Souber-ismael/Firmware-temps-r-el-STM32-FreeRTOS-Data-Logger-/image/monotoring system.jpeg

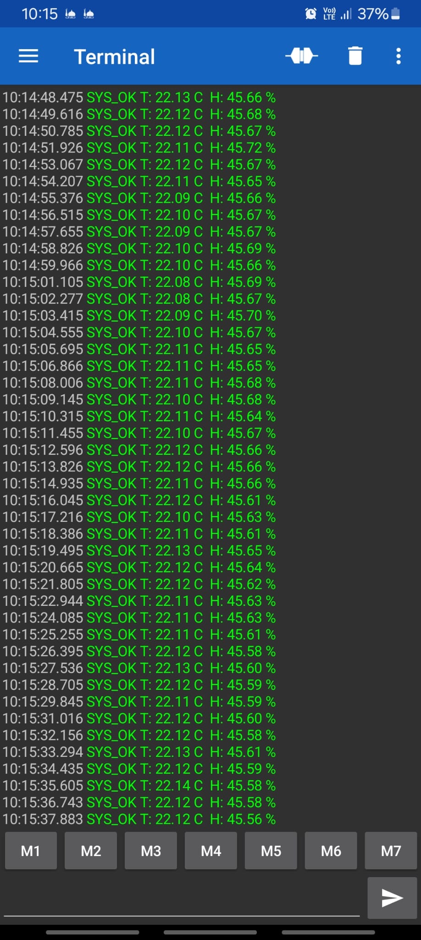
image/monotoring system.jpeg
