Souber-ismael/Firmware-temps-r-el-STM32-FreeRTOS-Data-Logger-/image/projet.jpeg

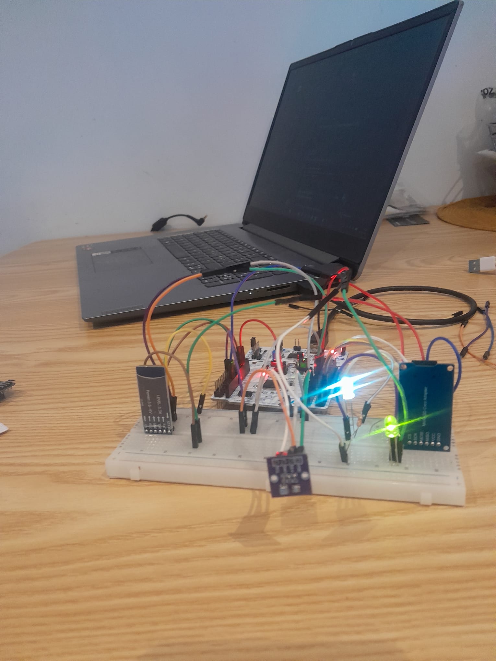
image/projet.jpeg
