Souber-ismael/Firmware-temps-r-el-STM32-FreeRTOS-Data-Logger-/image/recovery 3 ok.jpeg

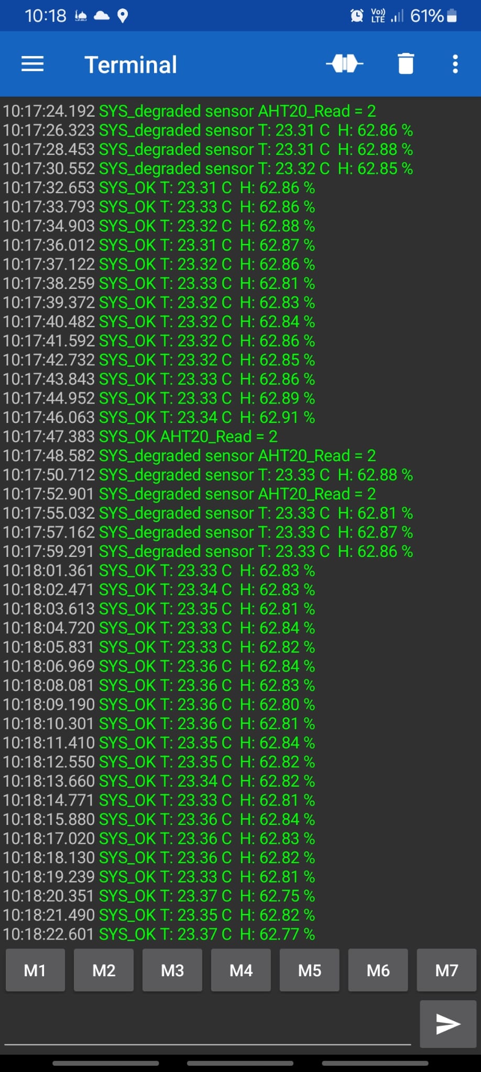
image/recovery 3 ok.jpeg
