Souber-ismael/Firmware-temps-r-el-STM32-FreeRTOS-Data-Logger-/image/the laptop.jpeg

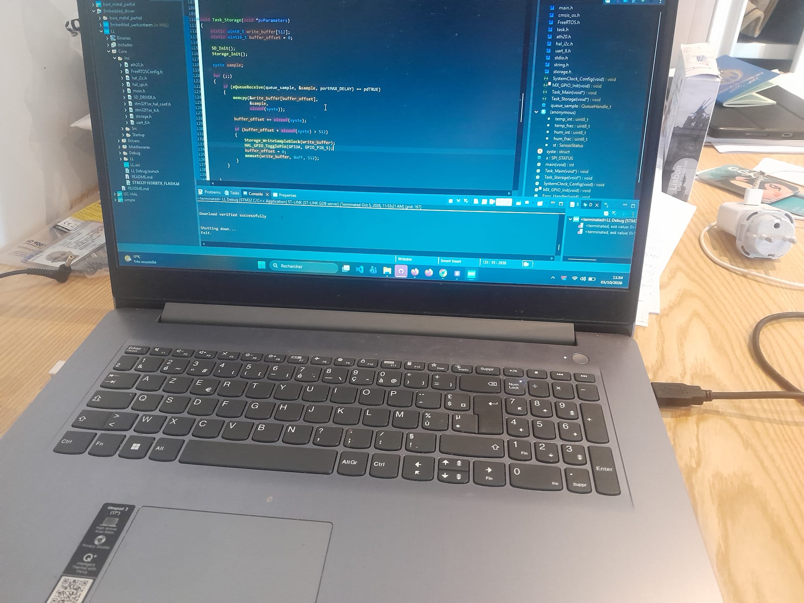
image/the laptop.jpeg
