Souber-ismael/Firmware-temps-r-el-STM32-FreeRTOS-Data-Logger-/tests_SASE/test_projet/coverage.aht20_convert.c.4a7f78591ac0107006967368135403f9.html

# GCC Code Coverage Report

Directory: | ./
Coverage: | low: ≥ 0% medium: ≥ 75.0% high: ≥ 90.0%

| Coverage | Exec / Excl / Total
Lines: | 100.0% | 31 / 0 / 31
Functions: | 100.0% | 1 / 0 / 1
Branches: | 94.4% | 17 / 0 / 18

Driver/AHT20/aht20_convert.c

30 covered 0 uncovered 1 partial covered 0 excluded

Line | Branch | Exec | Source
1 | | | /*
2 | | | * aht20_convert.c
3 | | | *
4 | | | * Created on: Oct 12, 2026
5 | | | * Author: admin
6 | | | */
7
8
9
10 | | | #include "aht20_convert.h"
11 | | | #include "stddef.h"
12
13 | | 136 | SensorStatus aht20_convert(
14 | | | const uint8_t data[6],
15 | | | int16_t *temp_int,
16 | | | uint8_t *temp_frac,
17 | | | uint8_t *hum_int,
18 | | | uint8_t *hum_frac)
19 | | | {
20 | 3/4 ✓ Branch 2 → 3 taken 136 times. ✗ Branch 2 → 7 not taken. ✓ Branch 3 → 4 taken 123 times. ✓ Branch 3 → 7 taken 13 times. | 136 | if (data == NULL
21 | 4/4 ✓ Branch 4 → 5 taken 121 times. ✓ Branch 4 → 7 taken 2 times. ✓ Branch 5 → 6 taken 119 times. ✓ Branch 5 → 7 taken 2 times. | 123 | temp_int == NULL || temp_frac == NULL
22 | 2/2 ✓ Branch 6 → 7 taken 1 time. ✓ Branch 6 → 8 taken 118 times. | 119 | hum_int == NULL || hum_frac == NULL)
23 | | | {
24 | | 18 | return SENSOR_STATUS_INVALID_DATA;
25 | | | }
26
27 | | | /* Extraction des valeurs brutes sur 20 bits */
28 | | 118 | uint32_t rawHum =
29 | | 118 | ((uint32_t)data[1] << 12)
30 | | 118 | ((uint32_t)data[2] << 4)
31 | | 118 | ((uint32_t)data[3] >> 4);
32
33 | | 118 | uint32_t rawTemp =
34 | | 118 | ((uint32_t)(data[3] & 0x0F) << 16)
35 | | 118 | ((uint32_t)data[4] << 8)
36 | | 118 | (uint32_t)data[5];
37
38 | | | /* Calcul en centiÃ¨mes pour Ã©viter les float */
39 | | 118 | uint32_t hum_centi =
40 | | 118 | (uint32_t)(((uint64_t)rawHum * 10000ULL)
41 | | 118 | / 1048576ULL);
42
43 | | 118 | int32_t temp_centi =
44 | | 118 | (int32_t)(((uint64_t)rawTemp * 20000ULL)
45 | | 118 | / 1048576ULL) - 5000;
46
47 | | | /* SÃ©parer partie entiÃ¨re et fraction */
48 | | 118 | *hum_int = (uint8_t)(hum_centi / 100);
49 | | 118 | *hum_frac = (uint8_t)(hum_centi % 100);
50
51 | | 118 | *temp_int = (int16_t)(temp_centi / 100);
52
53 | | 118 | int32_t frac = temp_centi % 100;
54 | 2/2 ✓ Branch 8 → 9 taken 26 times. ✓ Branch 8 → 10 taken 92 times. | 118 | if (frac < 0)
55 | | | {
56 | | 26 | frac = -frac;
57 | | | }
58
59 | | 118 | *temp_frac = (uint8_t)frac;
60
61 | | | /* VÃ©rification des plages */
62 | 2/2 ✓ Branch 10 → 11 taken 97 times. ✓ Branch 10 → 13 taken 21 times. | 118 | if (*temp_int > SENSOR_TEMP_MAX
63 | 2/2 ✓ Branch 11 → 12 taken 81 times. ✓ Branch 11 → 13 taken 16 times. | 97 | *temp_int < SENSOR_TEMP_MIN
64 | 2/2 ✓ Branch 12 → 13 taken 3 times. ✓ Branch 12 → 14 taken 78 times. | 81 | *hum_int > SENSOR_HUM_MAX)
65 | | | {
66 | | 40 | return SENSOR_STATUS_INVALID_DATA;
67 | | | }
68
69 | | 78 | return SENSOR_STATUS_OK;
70 | | | }
71

Created using GCOVR (Version 8.6) (http://gcovr.com/en/8.6) at 2026-10-18 17:52:37
