Souber-ismael/Firmware-temps-r-el-STM32-FreeRTOS-Data-Logger-/tests_SASE/test_projet/coverage.functions.html

# GCC Code Coverage Report

Directory: | ./

| Coverage | Exec | Excl | Total
Lines: | 98.3% | 118 | 0 | 120
Functions: | 100.0% | 10 | 0 | 10
Branches: | 94.8% | 55 | 0 | 58

Function (File:Line)

Calls

Lines

Branches

Blocks

Storage_Init (Driver/storage/storage.c:28)

called 57 times

100.0%

100.0%

100.0%

Storage_SaveMetadata (Driver/storage/storage.c:53)

called 76 times

100.0%

-%

100.0%

Storage_WriteSampleBlock (Driver/storage/storage.c:72)

called 57 times

100.0%

100.0%

100.0%

aht20_convert (Driver/AHT20/aht20_convert.c:13)

called 136 times

100.0%

94.4%

100.0%

supervisor_check_timeouts (APP/task_supervisor/supervisor_logic.c:118)

called 777 times

100.0%

100.0%

100.0%

supervisor_ok_sensor (APP/task_supervisor/supervisor_logic.c:100)

called 567 times

100.0%

100.0%

100.0%

supervisor_ok_storage (APP/task_supervisor/supervisor_logic.c:109)

called 210 times

100.0%

100.0%

100.0%

supervisor_process_event (APP/task_supervisor/supervisor_logic.c:33)

called 714 times

92.3%

88.2%

94.7%

supervisor_reset (APP/task_supervisor/supervisor_logic.c:22)

called 378 times

100.0%

-%

100.0%

supervisor_update (APP/task_supervisor/supervisor_logic.c:81)

called 861 times

100.0%

100.0%

100.0%

Created using GCOVR (Version 8.6) (http://gcovr.com/en/8.6) at 2026-10-18 17:52:37
