Souber-ismael/Firmware-temps-r-el-STM32-FreeRTOS-Data-Logger-/tests_SASE/test_projet/coverage.html

# GCC Code Coverage Report

Directory: | ./
Coverage: | low: ≥ 0% medium: ≥ 75.0% high: ≥ 90.0%

| Coverage | Exec / Excl / Total
Lines: | 98.3% | 118 / 0 / 120
Functions: | 100.0% | 10 / 0 / 10
Branches: | 94.8% | 55 / 0 / 58

File

Lines

Functions

Branches

APP/task_supervisor/supervisor_logic.c

97.1

97.1% 66 / 0 / 68

100.0% 6 / 0 / 6

93.8% 30 / 0 / 32

Driver/AHT20/aht20_convert.c

100.0

100.0% 31 / 0 / 31

100.0% 1 / 0 / 1

94.4% 17 / 0 / 18

Driver/storage/storage.c

100.0

100.0% 21 / 0 / 21

100.0% 3 / 0 / 3

100.0% 8 / 0 / 8

Created using GCOVR (Version 8.6) (http://gcovr.com/en/8.6) at 2026-10-18 17:52:37
