Souber-ismael/Firmware-temps-r-el-STM32-FreeRTOS-Data-Logger-/tests_SASE/test_projet/coverage.storage.c.df7cba96553eae70c01e21275d564a91.html

# GCC Code Coverage Report

Directory: | ./
Coverage: | low: ≥ 0% medium: ≥ 75.0% high: ≥ 90.0%

| Coverage | Exec / Excl / Total
Lines: | 100.0% | 21 / 0 / 21
Functions: | 100.0% | 3 / 0 / 3
Branches: | 100.0% | 8 / 0 / 8

Driver/storage/storage.c

21 covered 0 uncovered 0 partial covered 0 excluded

Line | Branch | Exec | Source
1 | | | ï»¿/**
2 | | | * @file storage.c
3 | | | * @brief Implementation de la couche de stockage logique sur microSD.
4 | | | *
5 | | | * @details Gere l organisation circulaire des blocs de journal sur la SD.
6 | | | * Les metadonnees (pointeur de bloc courant) sont persistees au
7 | | | * bloc SD_META_BLOCK apres chaque ecriture pour garantir la
8 | | | * reprise correcte apres un redemarrage ou un reset watchdog.
9 | | | */
10
11 | | | #include "storage.h"
12
13 | | | /** @brief Numero du prochain bloc de journal a ecrire. Persiste sur SD. */
14 | | | #ifdef TEST
15 | | | uint32_t current_block;
16 | | | #else
17 | | | static uint32_t current_block;
18 | | | #endif
19
20 | | | /**
21 | | | * @brief Initialise la couche de stockage et reprend le pointeur de bloc.
22 | | | * @details Lit le bloc SD_META_BLOCK. Si le magic correspond a SD_META_MAGIC,
23 | | | * reprend current_block a la valeur persistee.
24 | | | * Sinon (premiere utilisation ou SD vierge), repart de
25 | | | * SD_LOG_START_BLOCK et ecrit les metadonnees initiales.
26 | | | * @retval SD_OK Toujours retourne SD_OK.
27 | | | */
28 | | 57 | SD_Status Storage_Init(void)
29 | | | {
30 | | | SD_Metadata_t meta;
31
32 | | 57 | SD_Status ret = SD_READBLOC(SD_META_BLOCK, (uint8_t *)&meta);
33
34 | 4/4 ✓ Branch 3 → 4 taken 38 times. ✓ Branch 3 → 6 taken 19 times. ✓ Branch 4 → 5 taken 19 times. ✓ Branch 4 → 6 taken 19 times. | 57 | if (ret == SD_OK && meta.magic == SD_META_MAGIC) {
35 | | | /* Metadonnees valides : reprise du journal a l endroit exact */
36 | | 19 | current_block = meta.current_block;
37 | | | } else {
38 | | | /* Premiere utilisation ou metadonnees corrompues : reinitialisation */
39 | | 38 | current_block = SD_LOG_START_BLOCK;
40 | | 38 | Storage_SaveMetadata();
41 | | | }
42
43 | | 57 | return SD_OK;
44 | | | }
45
46 | | | /**
47 | | | * @brief Persiste le pointeur de bloc courant sur la microSD.
48 | | | * @details Remplit la structure SD_Metadata_t avec le magic et current_block,
49 | | | * puis ecrit le bloc au numero SD_META_BLOCK.
50 | | | * @retval SD_OK Sauvegarde reussie.
51 | | | * @retval SD_ERROR Erreur lors de l ecriture SPI/SD.
52 | | | */
53 | | 76 | SD_Status Storage_SaveMetadata(void)
54 | | | {
55 | | 76 | SD_Metadata_t meta = {0};
56
57 | | 76 | meta.magic = SD_META_MAGIC;
58 | | 76 | meta.current_block = current_block;
59
60 | | 76 | return SD_WriteBlock(SD_META_BLOCK, (uint8_t *)&meta);
61 | | | }
62
63 | | | /**
64 | | | * @brief Ecrit un bloc de donnees de 512 octets dans le journal et avance le pointeur.
65 | | | * @details Ecrit data_block au bloc current_block, incremente le compteur,
66 | | | * applique la rotation circulaire si la fin du journal est atteinte,
67 | | | * puis appelle Storage_SaveMetadata() pour persister le nouvel etat.
68 | | | * @param[in] data_block Buffer de 512 octets a ecrire sur la SD.
69 | | | * @retval SD_OK Ecriture et mise a jour des metadonnees reussies.
70 | | | * @retval SD_ERROR Erreur lors de l ecriture du bloc de donnees.
71 | | | */
72 | | 57 | SD_Status Storage_WriteSampleBlock(uint8_t *data_block)
73 | | | {
74 | | | SD_Status ret;
75
76 | | 57 | ret = SD_WriteBlock(current_block, data_block);
77 | 2/2 ✓ Branch 3 → 4 taken 19 times. ✓ Branch 3 → 5 taken 38 times. | 57 | if (ret != SD_OK) {
78 | | 19 | return ret;
79 | | | }
80
81 | | 38 | current_block++;
82
83 | | | /* Rotation circulaire : retour au debut du journal si la fin est atteinte */
84 | 2/2 ✓ Branch 5 → 6 taken 19 times. ✓ Branch 5 → 7 taken 19 times. | 38 | if (current_block >= SD_LOG_START_BLOCK + SD_LOG_BLOCK_COUNT) {
85 | | 19 | current_block = SD_LOG_START_BLOCK;
86 | | | }
87
88 | | 38 | ret = Storage_SaveMetadata();
89
90 | | 38 | return ret;
91 | | | }
92

Created using GCOVR (Version 8.6) (http://gcovr.com/en/8.6) at 2026-10-18 17:52:37
