Souber-ismael/Firmware-temps-r-el-STM32-FreeRTOS-Data-Logger-/tests_SASE/test_projet/coverage.supervisor_logic.c.f8fc2ba87c13a68db147c01a740a686d.html

# GCC Code Coverage Report

Directory: | ./
Coverage: | low: ≥ 0% medium: ≥ 75.0% high: ≥ 90.0%

| Coverage | Exec / Excl / Total
Lines: | 97.1% | 66 / 0 / 68
Functions: | 100.0% | 6 / 0 / 6
Branches: | 93.8% | 30 / 0 / 32

APP/task_supervisor/supervisor_logic.c

64 covered 2 uncovered 2 partial covered 0 excluded

Line | Branch | Exec | Source
1 | | | /**
2 | | | * @file supervisor_logic.c
3 | | | * @brief Implementation portable de la machine d'etat superviseur.
4 | | | */
5
6 | | | #include "supervisor_logic.h"
7 | | | #include <stdbool.h>
8
9 | | | volatile SystemState_t current_state = STATE_RUNNING;
10
11 | | | static uint32_t sensor_ok_count = 0;
12 | | | static uint32_t storage_ok_count = 0;
13 | | | static uint32_t sensor_degraded_since = 0;
14 | | | static uint32_t storage_degraded_since = 0;
15 | | | static bool sensor_timer_active = false;
16 | | | static bool storage_timer_active = false;
17
18 | | | static void supervisor_ok_sensor(void);
19 | | | static void supervisor_ok_storage(void);
20 | | | static void supervisor_check_timeouts(uint32_t now_ms);
21
22 | | 378 | void supervisor_reset(void)
23 | | | {
24 | | 378 | current_state = STATE_RUNNING;
25 | | 378 | sensor_ok_count = 0;
26 | | 378 | storage_ok_count = 0;
27 | | 378 | sensor_degraded_since = 0;
28 | | 378 | storage_degraded_since = 0;
29 | | 378 | sensor_timer_active = false;
30 | | 378 | storage_timer_active = false;
31 | | 378 | }
32
33 | | 714 | void supervisor_process_event(const HealthReport_t *report, uint32_t now_ms)
34 | | | {
35 | 2/2 ✓ Branch 2 → 3 taken 21 times. ✓ Branch 2 → 4 taken 693 times. | 714 | if (report == NULL) {
36 | | 21 | return;
37 | | | }
38
39 | 2/3 ✓ Branch 4 → 5 taken 483 times. ✓ Branch 4 → 12 taken 210 times. ✗ Branch 4 → 19 not taken. | 693 | switch (report->source) {
40
41 | | 483 | case HEALTH_SRC_SENSOR:
42 | 2/2 ✓ Branch 5 → 6 taken 210 times. ✓ Branch 5 → 7 taken 273 times. | 483 | if (report->event == SYS_OK) {
43 | | 210 | sensor_ok_count++;
44 | | | } else {
45 | | 273 | sensor_ok_count = 0;
46
47 | 2/2 ✓ Branch 7 → 8 taken 252 times. ✓ Branch 7 → 9 taken 21 times. | 273 | if (current_state != STATE_STORAGE_DEGRADED) {
48 | | 252 | current_state = STATE_SENSOR_DEGRADED;
49 | | | }
50
51 | 2/2 ✓ Branch 9 → 10 taken 231 times. ✓ Branch 9 → 11 taken 42 times. | 273 | if (!sensor_timer_active) {
52 | | 231 | sensor_degraded_since = now_ms;
53 | | 231 | sensor_timer_active = true;
54 | | | }
55 | | | }
56 | | 483 | break;
57
58 | | 210 | case HEALTH_SRC_STORAGE:
59
60 | 2/2 ✓ Branch 12 → 13 taken 63 times. ✓ Branch 12 → 14 taken 147 times. | 210 | if (report->event == SYS_OK) {
61 | | 63 | storage_ok_count++;
62 | | | } else {
63 | | 147 | storage_ok_count = 0;
64
65 | 2/2 ✓ Branch 14 → 15 taken 126 times. ✓ Branch 14 → 16 taken 21 times. | 147 | if (current_state != STATE_SENSOR_DEGRADED) {
66 | | 126 | current_state = STATE_STORAGE_DEGRADED;
67
68 | | | }
69 | 1/2 ✓ Branch 16 → 17 taken 147 times. ✗ Branch 16 → 18 not taken. | 147 | if (!storage_timer_active) {
70 | | 147 | storage_degraded_since = now_ms;
71 | | 147 | storage_timer_active = true;
72 | | | }
73 | | | }
74 | | 210 | break;
75
76 | | ✗ | default:
77 | | ✗ | break;
78 | | | }
79 | | | }
80
81 | | 861 | void supervisor_update(uint32_t now_ms)
82 | | | {
83 | 3/3 ✓ Branch 2 → 3 taken 567 times. ✓ Branch 2 → 6 taken 210 times. ✓ Branch 2 → 9 taken 84 times. | 861 | switch (current_state) {
84
85 | | 567 | case STATE_SENSOR_DEGRADED:
86 | | 567 | supervisor_ok_sensor();
87 | | 567 | supervisor_check_timeouts(now_ms);
88 | | 567 | break;
89
90 | | 210 | case STATE_STORAGE_DEGRADED:
91 | | 210 | supervisor_ok_storage();
92 | | 210 | supervisor_check_timeouts(now_ms);
93 | | 210 | break;
94
95 | | 84 | default:
96 | | 84 | break;
97 | | | }
98 | | 861 | }
99
100 | | 567 | static void supervisor_ok_sensor(void)
101 | | | {
102 | 2/2 ✓ Branch 2 → 3 taken 21 times. ✓ Branch 2 → 4 taken 546 times. | 567 | if (sensor_ok_count >= STREAK_TO_RECOVER_Sensor) {
103 | | 21 | current_state = STATE_RUNNING;
104 | | 21 | sensor_degraded_since = 0;
105 | | 21 | sensor_timer_active = false;
106 | | | }
107 | | 567 | }
108
109 | | 210 | static void supervisor_ok_storage(void)
110 | | | {
111 | 2/2 ✓ Branch 2 → 3 taken 42 times. ✓ Branch 2 → 4 taken 168 times. | 210 | if (storage_ok_count >= STREAK_TO_RECOVER_storage) {
112 | | 42 | current_state = STATE_RUNNING;
113 | | 42 | storage_degraded_since = 0;
114 | | 42 | storage_timer_active = false;
115 | | | }
116 | | 210 | }
117
118 | | 777 | static void supervisor_check_timeouts(uint32_t now_ms)
119 | | | {
120 | 2/2 ✓ Branch 2 → 3 taken 567 times. ✓ Branch 2 → 5 taken 210 times. | 777 | if (sensor_timer_active &&
121 | 2/2 ✓ Branch 3 → 4 taken 84 times. ✓ Branch 3 → 5 taken 483 times. | 567 | (now_ms - sensor_degraded_since) >= DEGRADED_TO_FATAL_MS)
122 | | | {
123 | | 84 | current_state = STATE_FATAL_ERROR;
124 | | | }
125
126 | 2/2 ✓ Branch 5 → 6 taken 189 times. ✓ Branch 5 → 8 taken 588 times. | 777 | if (storage_timer_active &&
127 | 2/2 ✓ Branch 6 → 7 taken 21 times. ✓ Branch 6 → 8 taken 168 times. | 189 | (now_ms - storage_degraded_since) >= DEGRADED_TO_FATAL_MS)
128 | | | {
129 | | 21 | current_state = STATE_FATAL_ERROR;
130 | | | }
131 | | 777 | }
132

Created using GCOVR (Version 8.6) (http://gcovr.com/en/8.6) at 2026-10-18 17:52:37
