Souber-ismael/Firmware-temps-r-el-STM32-FreeRTOS-Data-Logger-/Driver/AHT20/aht20.c

#include "aht20.h"
#include "hal_i2c.h"
#include "uart_ll.h"

SensorStatus sensor_status;

SensorStatus AHT20_Init(void) {
	i2c_status_t st;

	st = hal_i2c_probe( AHT20_ADDR);

	if (st != I2C_OK) {
		return sensor_convert_i2c_status(st);
	}

	uint8_t reset_cmd[1] = { 0xBA };

	st = i2c_transmit(AHT20_ADDR, reset_cmd, 1, 200);
	if (st != I2C_OK) {
		return sensor_convert_i2c_status(st);
	}

	HAL_Delay(80);

	uint8_t status = 0;
	st = i2c_receive(AHT20_ADDR, &status, 1, 200);
	if (st != I2C_OK) {
		return sensor_convert_i2c_status(st);
	}

	if (!(status & 0x08)) {
		uint8_t cmd[3] = { 0xBE, 0x08, 0x00 };
		st = i2c_transmit(AHT20_ADDR, cmd, 3, 200);
		if (st != I2C_OK) {
			return sensor_convert_i2c_status(st);
		}

		HAL_Delay(40);

		st = i2c_receive(AHT20_ADDR, &status, 1, 200);

		if (st != I2C_OK) {
			return sensor_convert_i2c_status(st);
		}

		if (!(status & 0x08)) {
			return SENSOR_NOT_CALIBRATED;
		}

		return SENSOR_STATUS_OK;
	}

	return SENSOR_STATUS_OK;
}

SensorStatus AHT20_Read(int16_t *temp_int, uint8_t *temp_frac, uint8_t *hum_int,
		uint8_t *hum_frac) {

	uint8_t cmd[3] = { 0xAC, 0x33, 0x00 };
	i2c_status_t st;
	uint8_t data[6];
	uint8_t retries = 0;

	st = i2c_transmit(AHT20_ADDR, cmd, 3, 200);
	if (st != I2C_OK) {
		return sensor_convert_i2c_status(st);
	}

	do {
		st = i2c_receive(AHT20_ADDR, data, 6, 200);
		if (st == I2C_OK)
			break;
		retries++;
		HAL_Delay(20);
	} while (retries < 5);

	if (st != I2C_OK)
		return sensor_convert_i2c_status(st);

	HAL_Delay(80);

	if (data[0] & 0x80) {
		HAL_Delay(20);
		st = i2c_receive(AHT20_ADDR, data, 6, 200);
		if (st != I2C_OK) {
			return sensor_convert_i2c_status(st);
		}
		if (data[0] & 0x80) {
			return SENSOR_STATUS_BUSY;
		}
	}

	return(aht20_convert(data, temp_int, temp_frac, hum_int, hum_frac));

}

SensorStatus sensor_convert_i2c_status(i2c_status_t i2c_status) {

	switch (i2c_status) {
	case I2C_OK:
		return SENSOR_STATUS_OK;

	case I2C_ERR_NACK:
		return SENSOR_STATUS_NOT_FOUND;

	case I2C_ERR_TIMEOUT:
		return SENSOR_COMMUNICATION_ERROR;

	case I2C_ERR_BUSY:
		return SENSOR_COMMUNICATION_ERROR;

	case I2C_ERR_HAL:
		return SENSOR_COMMUNICATION_ERROR;

	default:
		return SENSOR_STATUS_BUS_ERROR;
	}
}
