Souber-ismael/Firmware-temps-r-el-STM32-FreeRTOS-Data-Logger-/(commit log)

2026-10-06 ajout de tache pour le capteur et le stockage
2026-10-06 petit systeme de supervision qui fonctionne
2026-10-08 ajout de state dans le superviseur et affichage de erreur
2026-10-09 ajout de watchdog
2026-10-09 Refactor: réorganisation de la structure du projet (Drivers + App)
2026-10-10 les images
2026-10-16 suppression de main dans Tests pour ceedling
2026-10-16 suppression de main dans le storage
2026-10-20 fix: correct path case for Linux CI
2026-10-20 fix: Driver/storage case in :source
